Jaamorn/intelligent-car-SMU15/Documents/matlab上位机/qinaidi.JPG

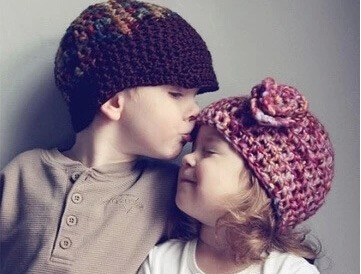
Documents/matlab上位机/qinaidi.JPG
