Jaamorn/intelligent-car-SMU15/(list of files, drawings)

Other design files:
Documents/稳压电路说明/稳压&外部AD.SchDoc
