Jaamorn/intelligent-car-SMU15/main_program/Board/src/lcd.c

#include  "common.h"
#include "lcd.h"
#include "MK60_gpio.h"



#define XLevelL		0x00
#define XLevelH		0x10
#define XLevel		((XLevelH&0x0F)*16+XLevelL)
#define Max_Column	128
#define Max_Row		  64
#define	Brightness	0xCF 

/*
4线SPI使用说明：
VBT 供内部DC-DC电压，3.3~4.3V，如果使用5V电压，为保险起见串一个100~500欧的电阻
VCC 供内部逻辑电压 1.8~6V   
GND 地

BS0 低电平
BS1 低电平
BS2 低电平

CS  片选管脚
DC  命令数据选择管脚                                                                          PTC 4
RES 模块复位管脚                                                                                     PTC 0
D0（SCLK） ，时钟脚，由MCU控制                                                  PTC 7
D1（MOSI） ，主输出从输入数据脚，由MCU控制                 PTC 6

D2 悬空      
D3-D7 ， 低电平 ， 也可悬空，但最好设为低电平
RD  低电平 ，也可悬空，但最好设为低电平
RW  低电平 ，也可悬空，但最好设为低电平
RD  低电平 ，也可悬空，但最好设为低电平   
*/

#define X_WIDTH 128
#define Y_WIDTH 64
//======================================
const byte F6x8[][6] =
{
    { 0x00, 0x00, 0x00, 0x00, 0x00, 0x00 },   // sp
    { 0x00, 0x00, 0x00, 0x2f, 0x00, 0x00 },   // !
    { 0x00, 0x00, 0x07, 0x00, 0x07, 0x00 },   // "
    { 0x00, 0x14, 0x7f, 0x14, 0x7f, 0x14 },   // #
    { 0x00, 0x24, 0x2a, 0x7f, 0x2a, 0x12 },   // $
    { 0x00, 0x62, 0x64, 0x08, 0x13, 0x23 },   // %
    { 0x00, 0x36, 0x49, 0x55, 0x22, 0x50 },   // &
    { 0x00, 0x00, 0x05, 0x03, 0x00, 0x00 },   // '
    { 0x00, 0x00, 0x1c, 0x22, 0x41, 0x00 },   // (
    { 0x00, 0x00, 0x41, 0x22, 0x1c, 0x00 },   // )
    { 0x00, 0x14, 0x08, 0x3E, 0x08, 0x14 },   // *
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
  0X00,0X00,0X00,0X00,0X00,0X00,0X00,0X00,0X00,0X00,0X00,0X00,0X00,0X00,0X00,0X00,
  0X00,0X03,0X07,0X0F,0X0F,0X07,0X01,0X00,0X00,0X00,0X00,0X00,0X00,0X00,0X00,0X00,
  0X00,0X00,0X00,0X00,0X00,0X00,0X00,0X00,0X00,0X00,0X00,0X00,0X00,0X00,0X00,0X00,
}; 


void LCD_WrDat(byte data)
{
	byte i=8;
	//LCD_CS=0;;
	GPIOC_PDOR |=  GPIO_PDOR_PDO(GPIO_PIN(19));;;;
        asm("nop"); 
      GPIOC_PDOR &= ~GPIO_PDOR_PDO(GPIO_PIN(16));;;;
      asm("nop");    
  while(i--)
  {
    if(data&0x80){GPIOC_PDOR |=  GPIO_PDOR_PDO(GPIO_PIN(17));;;;}
    else{GPIOC_PDOR &= ~GPIO_PDOR_PDO(GPIO_PIN(17));;;;}
    GPIOC_PDOR |=  GPIO_PDOR_PDO(GPIO_PIN(16)); 
    asm("nop");;;;
		//asm("nop");            
    GPIOC_PDOR &= ~GPIO_PDOR_PDO(GPIO_PIN(16));;;;;    
    data<<=1;    
  }
	//LCD_CS=1;
}
void LCD_WrCmd(byte cmd)
{
	byte i=8;
	
	//LCD_CS=0;;
  GPIOC_PDOR &= ~GPIO_PDOR_PDO(GPIO_PIN(19));;;;;
  GPIOC_PDOR &= ~GPIO_PDOR_PDO(GPIO_PIN(16));;;;;
  //asm("nop");   
  while(i--)
  {
    if(cmd&0x80){GPIOC_PDOR |=  GPIO_PDOR_PDO(GPIO_PIN(17));;;;;}
    else{GPIOC_PDOR &= ~GPIO_PDOR_PDO(GPIO_PIN(17));;;;;;}
    GPIOC_PDOR |=  GPIO_PDOR_PDO(GPIO_PIN(16));;;;;
    asm("nop");;;;
		//asm("nop");             
    GPIOC_PDOR &= ~GPIO_PDOR_PDO(GPIO_PIN(16));;;;;    
    cmd<<=1;;;;;   
  } 	
	//LCD_CS=1;
}
void LCD_Set_Pos(byte x, byte y)
{ 
  LCD_WrCmd(0xb0+y);
  LCD_WrCmd(((x&0xf0)>>4)|0x10);
  LCD_WrCmd(x&0x0f);//|0x01);原来的版本图像整体右移一列，导致低128列移到第一列显示，不知道这么做是为什么，暂时先改回来
} 
void LCD_Fill(byte bmp_data)
{
	byte y,x;
	
	for(y=0;y<8;y++)
	{
		LCD_WrCmd(0xb0+y);
		LCD_WrCmd(0x01);
		LCD_WrCmd(0x10);
		for(x=0;x<X_WIDTH;x++)
			LCD_WrDat(bmp_data);
	}
}
void LCD_CLS(void)
{
	byte y,x;	
	for(y=0;y<8;y++)
	{
		LCD_WrCmd(0xb0+y);
		LCD_WrCmd(0x01);
		LCD_WrCmd(0x10); 
		for(x=0;x<X_WIDTH;x++)
			LCD_WrDat(0);
	}
}
void LCD_DLY_ms(word ms)
{                         
  word a;
  while(ms)
  {
    a=13350;
    while(a--);
    ms--;
  }
  return;
}

void LCD_Init(void)        
{
  PORTC_PCR16=(0|PORT_PCR_MUX(1));
  PORTC_PCR17=(0|PORT_PCR_MUX(1)); 
  PORTC_PCR18=(0|PORT_PCR_MUX(1));
  PORTC_PCR19=(0|PORT_PCR_MUX(1));  

  GPIOC_PDDR=GPIO_PDDR_PDD(GPIO_PIN(18)|GPIO_PIN(19)|GPIO_PIN(16)|GPIO_PIN(17));
  GPIOC_PDOR |=  GPIO_PDOR_PDO(GPIO_PIN(16));
  //LCD_CS=1;	//预制SLK和SS为高电平   	 
  GPIOC_PDOR &= ~GPIO_PDOR_PDO(GPIO_PIN(18));
  LCD_DLY_ms(50);
  GPIOC_PDOR |=  GPIO_PDOR_PDO(GPIO_PIN(18));

  LCD_WrCmd(0xae);//--turn off oled panel
  LCD_WrCmd(0x00);//---set low column address
  LCD_WrCmd(0x10);//---set high column address
  LCD_WrCmd(0x40);//--set start line address  Set Mapping RAM Display Start Line (0x00~0x3F)
  LCD_WrCmd(0x81);//--set contrast control register
  LCD_WrCmd(0xcf); // Set SEG Output Current Brightness
  LCD_WrCmd(0xa1);//--Set SEG/Column Mapping     0xa0左右反置 0xa1正常
  LCD_WrCmd(0xc8);//Set COM/Row Scan Direction   0xc0上下反置 0xc8正常
  LCD_WrCmd(0xa6);//--set normal display
  LCD_WrCmd(0xa8);//--set multiplex ratio(1 to 64)
  LCD_WrCmd(0x3f);//--1/64 duty
  LCD_WrCmd(0xd3);//-set display offset	Shift Mapping RAM Counter (0x00~0x3F)
  LCD_WrCmd(0x00);//-not offset
  LCD_WrCmd(0xd5);//--set display clock divide ratio/oscillator frequency
  LCD_WrCmd(0x80);//--set divide ratio, Set Clock as 100 Frames/Sec
  LCD_WrCmd(0xd9);//--set pre-charge period
  LCD_WrCmd(0xf1);//Set Pre-Charge as 15 Clocks & Discharge as 1 Clock
  LCD_WrCmd(0xda);//--set com pins hardware configuration
  LCD_WrCmd(0x12);
  LCD_WrCmd(0xdb);//--set vcomh
  LCD_WrCmd(0x40);//Set VCOM Deselect Level
  LCD_WrCmd(0x20);//-Set Page Addressing Mode (0x00/0x01/0x02)
  LCD_WrCmd(0x02);//
  LCD_WrCmd(0x8d);//--set Charge Pump enable/disable
  LCD_WrCmd(0x14);//--set(0x10) disable
  LCD_WrCmd(0xa4);// Disable Entire Display On (0xa4/0xa5)
  LCD_WrCmd(0xa6);// Disable Inverse Display On (0xa6/a7) 
  LCD_WrCmd(0xaf);//--turn on oled panel
  LCD_Fill(0x00);  //初始清屏
  LCD_Set_Pos(0,0);  
	
} 
//==============================================================
//函数名： void LCD_PutPixel(byte x,byte y)
//功能描述：绘制一个点（x,y）
//参数：真实坐标值(x,y),x的范围0～127，y的范围0～64
//返回：无
//==============================================================
void LCD_PutPixel(byte x,byte y)
{
	byte data1;  //data1当前点的数据 
	 
        LCD_Set_Pos(x,y); 
	data1 = 0x01<<(y%8); 	
	LCD_WrCmd(0xb0+(y>>3));
	LCD_WrCmd(((x&0xf0)>>4)|0x10);
	LCD_WrCmd((x&0x0f)|0x00);
	LCD_WrDat(data1); 	 	
}

uint8 OLED_GRAM[128][8];

void OLED_Refresh_Gram(void)
{
	uint8 i,n;		    
	for(i=0;i<8;i++)  
	{  
		LCD_WrCmd (0xb0+i);    
		LCD_WrCmd (0x00);      
		LCD_WrCmd (0x10);      
		for(n=0;n<128;n++)LCD_WrDat(OLED_GRAM[n][i]); 
	}   
}


void OLED_DrawPoint(uint8 x,uint8 y,uint8 t)
{
	uint8 pos,bx,temp=0;
	if(x>127||y>63)return;
	pos=7-y/8;
	bx=y%8;
	temp=1<<(7-bx);
	if(t)OLED_GRAM[x][pos]|=temp;
	else OLED_GRAM[x][pos]&=~temp;
	
}
//==============================================================
//函数名： void LCD_Rectangle(byte x1,byte y1,
//                   byte x2,byte y2,byte color,byte gif)
//功能描述：绘制一个实心矩形
//参数：左上角坐标（x1,y1）,右下角坐标（x2，y2）
//      其中x1、x2的范围0～127，y1，y2的范围0～63，即真实坐标值
//返回：无
//==============================================================
void LCD_Rectangle(byte x1,byte y1,byte x2,byte y2,byte gif)
{
	byte n; 
		
	LCD_Set_Pos(x1,y1>>3);
	for(n=x1;n<=x2;n++)
	{
		LCD_WrDat(0x01<<(y1%8)); 			
		if(gif == 1) 	LCD_DLY_ms(50);
	}  
	LCD_Set_Pos(x1,y2>>3);
  for(n=x1;n<=x2;n++)
	{
		LCD_WrDat(0x01<<(y2%8)); 			
		if(gif == 1) 	LCD_DLY_ms(5);
	}
	
}  
//==============================================================
//函数名：LCD_P6x8Str(byte x,byte y,byte *p)
//功能描述：写入一组标准ASCII字符串
//参数：显示的位置（x,y），y为页范围0～7，要显示的字符串
//返回：无
//==============================================================  
void LCD_P6x8Str(byte x,byte y,byte ch[])
{
  byte c=0,i=0,j=0;      
  while (ch[j]!='\0')
  {    
    c =ch[j]-32;
    if(x>126){x=0;y++;}
    LCD_Set_Pos(x,y);    
  	for(i=0;i<6;i++)     
  	  LCD_WrDat(F6x8[c][i]);  
  	x+=6;
  	j++;
  }
}
//==============================================================
//函数名：LCD_P8x16Str(byte x,byte y,byte *p)
//功能描述：写入一组标准ASCII字符串
//参数：显示的位置（x,y），y为页范围0～7，要显示的字符串
//返回：无
//==============================================================  
void LCD_P8x16Str(byte x,byte y,byte ch[])
{
  byte c=0,i=0,j=0;
        
  while (ch[j]!='\0')
  {    
    c =ch[j]-32;
    if(x>120){x=0;y++;}
    LCD_Set_Pos(x,y);    
  	for(i=0;i<8;i++)     
  	  LCD_WrDat(F8X16[c*16+i]);
  	LCD_Set_Pos(x,y+1);    
  	for(i=0;i<8;i++)     
  	  LCD_WrDat(F8X16[c*16+i+8]);  
  	x+=8;
  	j++;
  }
}
//输出汉字字符串
void LCD_P14x16Str(byte x,byte y,byte ch[])
{
	byte wm=0,ii = 0;
	word adder=1; 
	
	while(ch[ii] != '\0')
	{
  	wm = 0;
  	adder = 1;
  	while(F14x16_Idx[wm] > 127)
  	{
  		if(F14x16_Idx[wm] == ch[ii])
  		{
  			if(F14x16_Idx[wm + 1] == ch[ii + 1])
  			{
  				adder = wm * 14;
  				break;
  			}
  		}
  		wm += 2;			
  	}
  	if(x>118){x=0;y++;}
  	LCD_Set_Pos(x , y); 
  	if(adder != 1)// 显示汉字					
  	{
  		LCD_Set_Pos(x , y);
  		for(wm = 0;wm < 14;wm++)               
  		{
  			LCD_WrDat(F14x16[adder]);	
  			adder += 1;
  		}      
  		LCD_Set_Pos(x,y + 1); 
  		for(wm = 0;wm < 14;wm++)          
  		{
  			LCD_WrDat(F14x16[adder]);
  			adder += 1;
  		}   		
  	}
  	else			  //显示空白字符			
  	{
  		ii += 1;
      LCD_Set_Pos(x,y);
  		for(wm = 0;wm < 16;wm++)
  		{
  				LCD_WrDat(0);
  		}
  		LCD_Set_Pos(x,y + 1);
  		for(wm = 0;wm < 16;wm++)
  		{   		
  				LCD_WrDat(0);	
  		}
  	}
  	x += 14;
  	ii += 2;
	}
}


void LCD_write_char(uint8 X, uint8 Y,uint16 c)
{
 	 
    uint8 line;
	LCD_Set_Pos(X,Y);
    c -= 32;
    for (line=0; line<6; line++)
	{
        LCD_WrDat(F6x8[c][line]);
	}
}


void LCD_Show_Number (uint8 X,uint8 Y,uint16 number) 
{
  //LCD_write_char(X,Y,number/1000+48);
  LCD_write_char(X+6,Y,number%1000/100+48);
  LCD_write_char(X+12,Y,number%100/10+48);
  LCD_write_char(X+18,Y,number%10+48);
}


//输出汉字和字符混合字符串
void LCD_Print(byte x, byte y, byte ch[])
{
	byte ch2[3];
	byte ii=0;        
	while(ch[ii] != '\0')
	{
		if(ch[ii] > 127)
		{
			ch2[0] = ch[ii];
	 		ch2[1] = ch[ii + 1];
			ch2[2] = '\0';			//汉字为两个字节
			LCD_P14x16Str(x , y, ch2);	//显示汉字
			x += 14;
			ii += 2;
		}
		else
		{
			ch2[0] = ch[ii];	
			ch2[1] = '\0';			//字母占一个字节
			LCD_P8x16Str(x , y , ch2);	//显示字母
			x += 8;
			ii+= 1;
		}
	}
} 

//==============================================================
//函数名： void Draw_BMP(byte x,byte y)
//功能描述：显示BMP图片128×64
//参数：起始点坐标(x,y),x的范围0～127，y为页的范围0～7
//返回：无
//==============================================================
void Draw_BMP(byte x0,byte y0,byte x1,byte y1,uint8 bmp[])
{ 	
  word ii=0;
  byte x,y;
  
  if(y1%8==0) 
    y=y1/8;      
  else 
    y=y1/8+1;
  for(y=y0;y<=y1;y++)
  {
    LCD_Set_Pos(x0,y);				
    for(x=x0;x<=x1;x++)
    {      
      LCD_WrDat(bmp[ii++]);	    	
    }
  }
}
