Jaamorn/intelligent-car-SMU15/main_program/Board/inc/lcd.h

#ifndef	_LCD_H_
#define _LCD_H_
//#include "includes.h"

#define byte uint8
#define word uint16
#define GPIO_PIN_MASK      0x1Fu    //0x1f=31,限制位数为0--31有效
#define GPIO_PIN(x)        (((1)<<(x & GPIO_PIN_MASK)))  //把当前位置1
 extern byte beyond96x64[512];
 extern byte beyond64x64[512];
 void LCD_Init(void);
 void LCD_CLS(void);
 void LCD_P6x8Str(byte x,byte y,byte ch[]);
 void LCD_P8x16Str(byte x,byte y,byte ch[]);
 void LCD_P14x16Str(byte x,byte y,byte ch[]);
 void LCD_Print(byte x, byte y, byte ch[]);
 void LCD_PutPixel(byte x,byte y);
 void OLED_Refresh_Gram(void);
 void OLED_DrawPoint(uint8 x,uint8 y,uint8 t);
 void LCD_Rectangle(byte x1,byte y1,byte x2,byte y2,byte gif);
 void Draw_LQLogo(void);
 void Draw_LibLogo(void);
 void Draw_Image(void);
 void Draw_BMP(byte x0,byte y0,byte x1,byte y1,byte bmp[]); 
 void LCD_Fill(byte dat);
 void LCD_write_char(uint8 X,uint8 Y,uint16 c);
 void LCD_Show_Number(uint8 X,uint8 Y,uint16 number);
 
#endif
