Jaamorn/intelligent-car-SMU15/(commit log)

2015-10-17 第一次创建新文件
2015-10-17 添加入门pdf
2015-10-17 创建文档文件夹
2015-10-18 添加稳压电路说明
    [稳压&外部AD.SchDoc]
2015-12-12 添加主程序
    图像采集部分
2015-12-12 删除无用文件
2015-12-12 注释掉LCD显示程序
2015-12-13 烧录程序
2015-12-13 更改UART管脚
2015-12-15 更改UART4端口 采集图像
2015-12-15 UART测试
2015-12-15 摄像头调试
2015-12-16 替换采集程序
2015-12-16 添加上位机
2015-12-16 添加死区测定结果
2015-12-19 添加算法文档
2015-12-19 摄像头采集调试
    更改采集的行号
    更改采集差值
2015-12-19 更改图像采集宽度
    更改图像采集宽度为260
2015-12-20 调试图像
    调节图像宽度 调节行中断
2015-12-20 添加舵机保护程序
2015-12-24 添加舵机控制程序
    调整舵机保护程序
    写入舵机控制程序
2015-12-24 将舵机保护程序写入控制程序
2015-12-27 debug
    全整形
2015-12-30 换线后程序调试
    增加左右线丢失程序
2016-01-04 更换单片机，程序参数调整
    更换单片机为k60DN512Zxxx10
    更改图像识别行数
    调整中线识别程序
2016-01-05 舵机控制debug
    舵机控制程序debug
2016-01-07 加速程序
2016-01-20 改大框架
    更改最后一行寻点程序
    增加普通向上寻线程序
2016-01-24 寻线丟线debug
2016-01-24 丟线程序debug 添加调速程序
2016-01-25 加速程序debug
2016-01-30 添加注释
