Jaamorn/intelligent-car-SMU15/(notices)

Notices in the files:
main_program/Chip/src/MK60_ftm.c:
Copyright (c) 2013,Ò°»ð¿Æ¼¼
All rights reserved.
main_program/Board/inc/FIRE_NRF24L0.h:
(C) COPYRIGHT 2011 Ò°»ðÇ¶ÈëÊ½¿ª·¢¹¤×÷ÊÒ
